andersonvnicius/TCC/Documentation/beforetext/agradecimentos.tex

\addtotextpreliminarycontent{\lang{Acknowledgement}{Agradecimentos}}

\begin{agradecimentos}

\lang
{
    Greetings.
}
{

    Os meus agradecimentos são direcionados aos meus professores orientadores, o professor Andrea Piga Carboni que me nestes
    últimos 3 anos me acompanhou e orientou com extrema atenção desde o planejamento do trabalho até sua conclusão,
    e ao meu co-orientador, e o professor Marcos Alves Rabelo, pela excelente orientação sempre que necessário, principalmente
    nas etapas experimentais do trabalho.

}

\end{agradecimentos}

%Mesmo padrão da seção primária, porém sem indicativo numérico. Assim como: Dedicatória, Resumo, Abstract, Sumário, Listas, Referências, Apêndices e Anexos.
%
%
%Corpo do texto, fonte 10,5, justificado, recuo especial da primeira linha de 1 cm, espaçamento simples.
%
