andersonvnicius/TCC/Documentation/beforetext/siglas.tex

%\addtotextpreliminarycontent{\lang{List of Acronyms}{Lista de Siglas}}
%
%\begin{siglas}
%    \item[ABNT] \lang{Brazilian Association of Technical Standards}{Associação Brasileira de Normas Técnicas}
%    \item[abnTeX] \lang{Absurd Standards for TeX}{ABsurdas Normas para TeX}
%\end{siglas}
