andersonvnicius/TCC/Documentation/pictures/1040.png

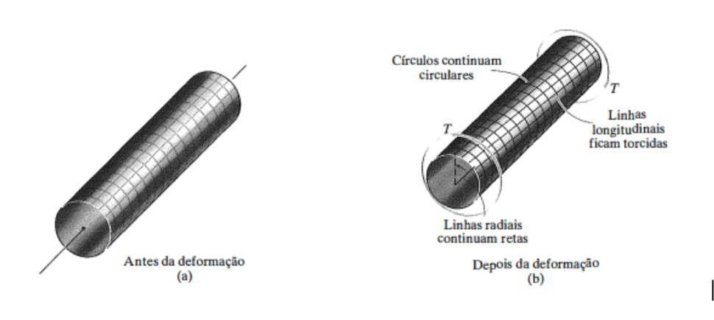
Documentation/pictures/1040.png
