andersonvnicius/TCC/Documentation/pictures/1050.png

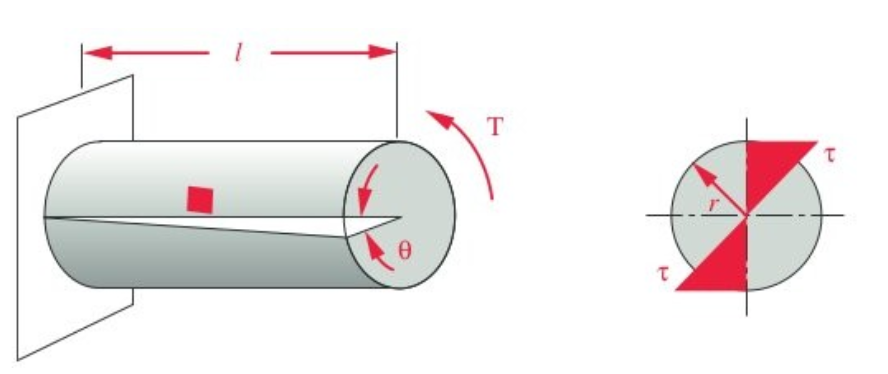
Documentation/pictures/1050.png
