andersonvnicius/TCC/Documentation/pictures/1130.jpg

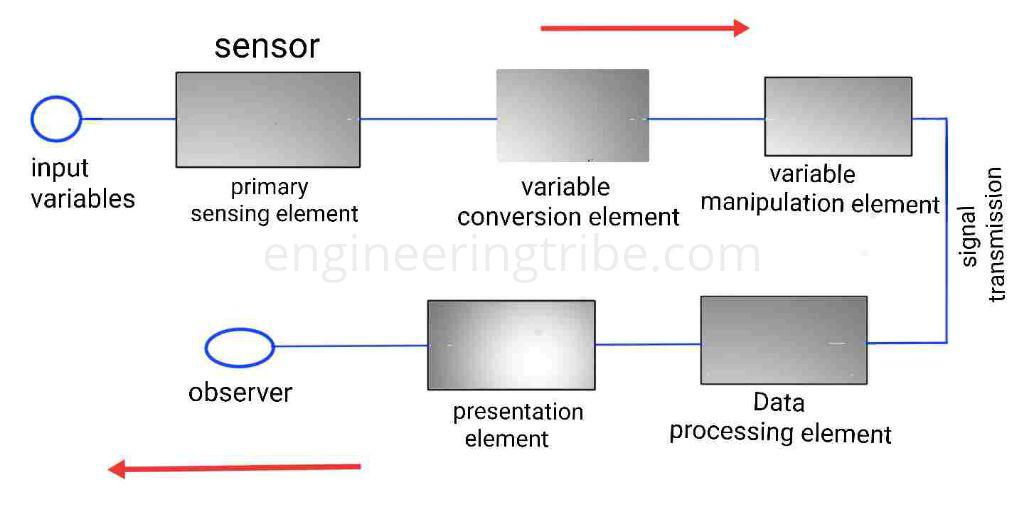
Documentation/pictures/1130.jpg
