andersonvnicius/TCC/Documentation/pictures/1140.png

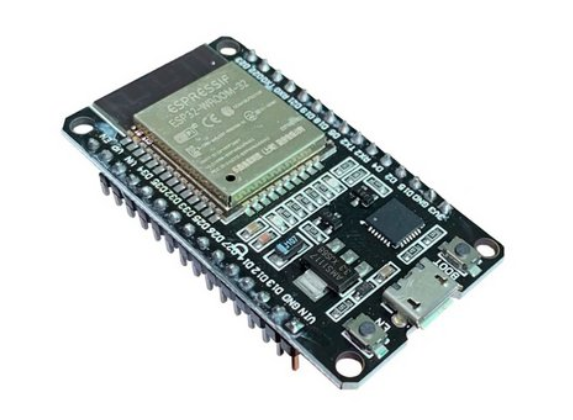
Documentation/pictures/1140.png
