andersonvnicius/TCC/Documentation/pictures/1160.png

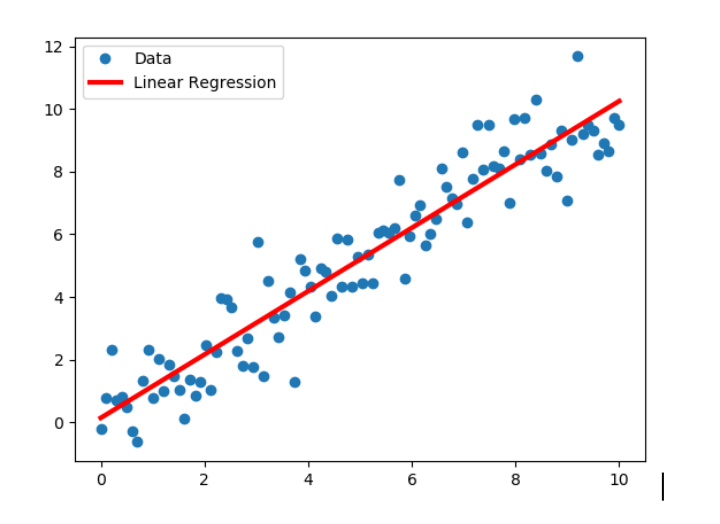
Documentation/pictures/1160.png
