andersonvnicius/TCC/Documentation/pictures/2020.jpg

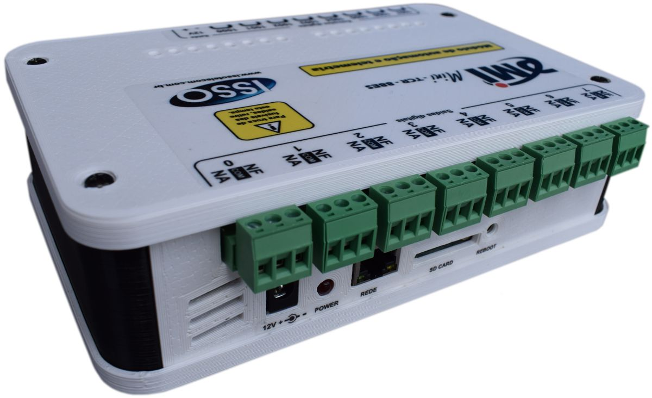
Documentation/pictures/2020.jpg
