andersonvnicius/TCC/Documentation/pictures/comp_func_reg.png

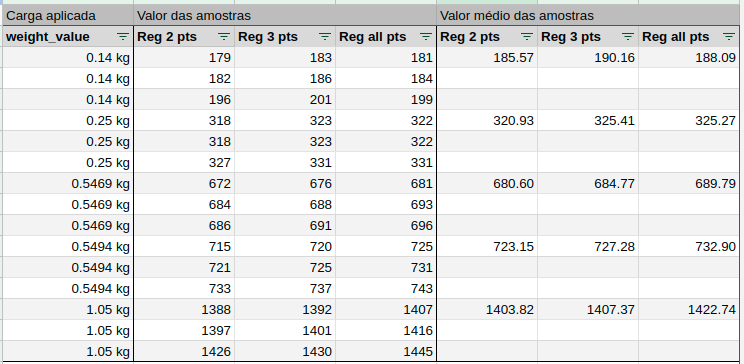
Documentation/pictures/comp_func_reg.png
