andersonvnicius/TCC/Documentation/pictures/comp_func_reg_erros.png

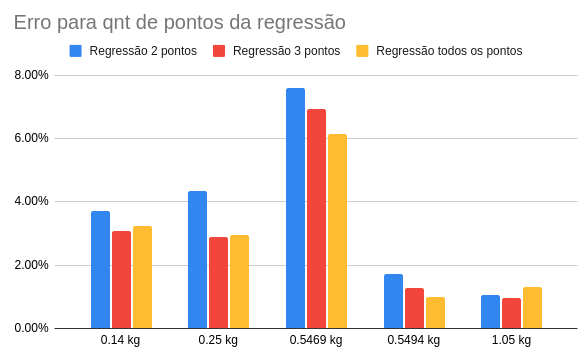
Documentation/pictures/comp_func_reg_erros.png
