andersonvnicius/TCC/Documentation/pictures/sep_24_1_deformation.png

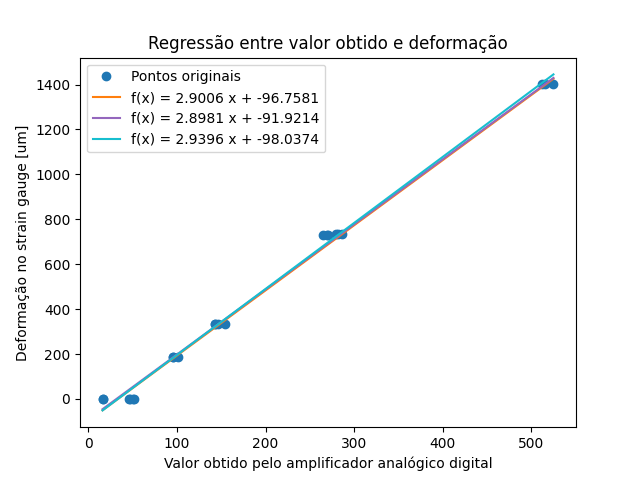
Documentation/pictures/sep_24_1_deformation.png
