andersonvnicius/TCC/Documentation/pictures/sep_24_1_weight.png

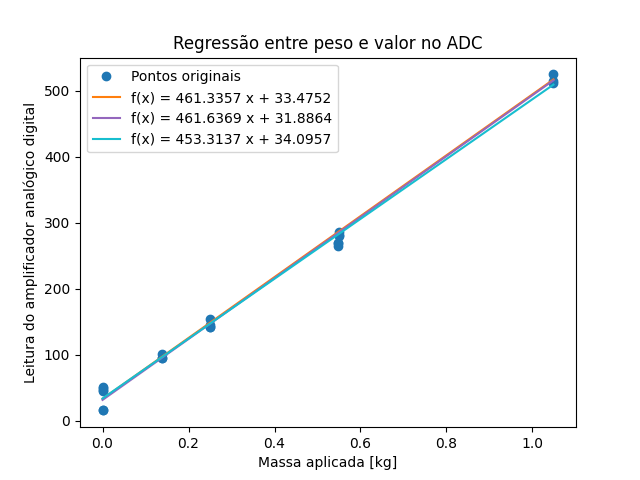
Documentation/pictures/sep_24_1_weight.png
