andersonvnicius/TCC/Documentation/pictures/t110.png

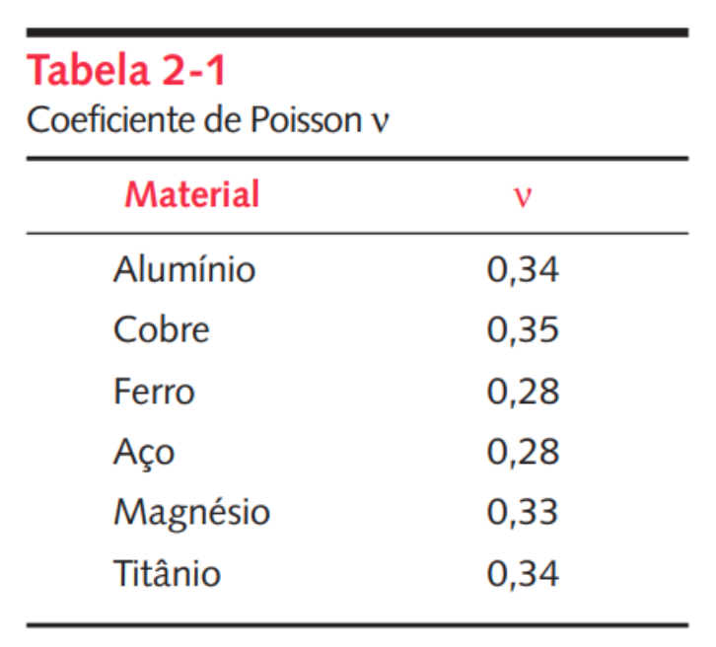
Documentation/pictures/t110.png
