andersonvnicius/TCC/Documentation/pictures/val_func_cal.png

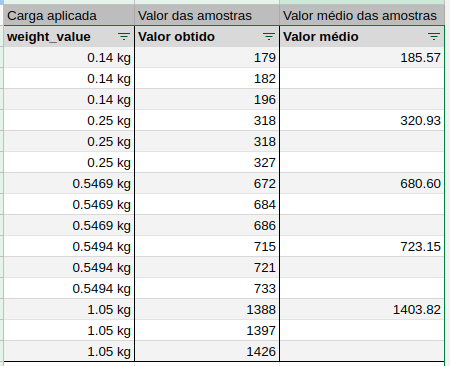
Documentation/pictures/val_func_cal.png
