andersonvnicius/TCC/Documentation/pictures/x_cal_0.png

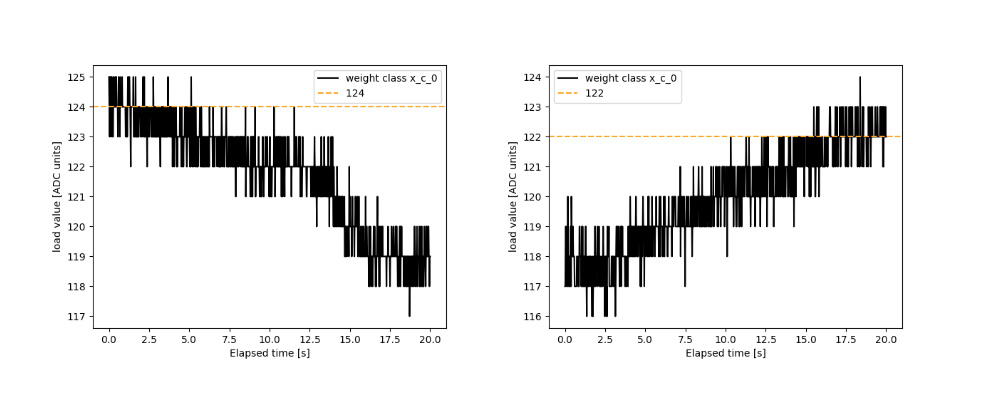
Documentation/pictures/x_cal_0.png
