andersonvnicius/TCC/Documentation/pictures/X_cal_1.png

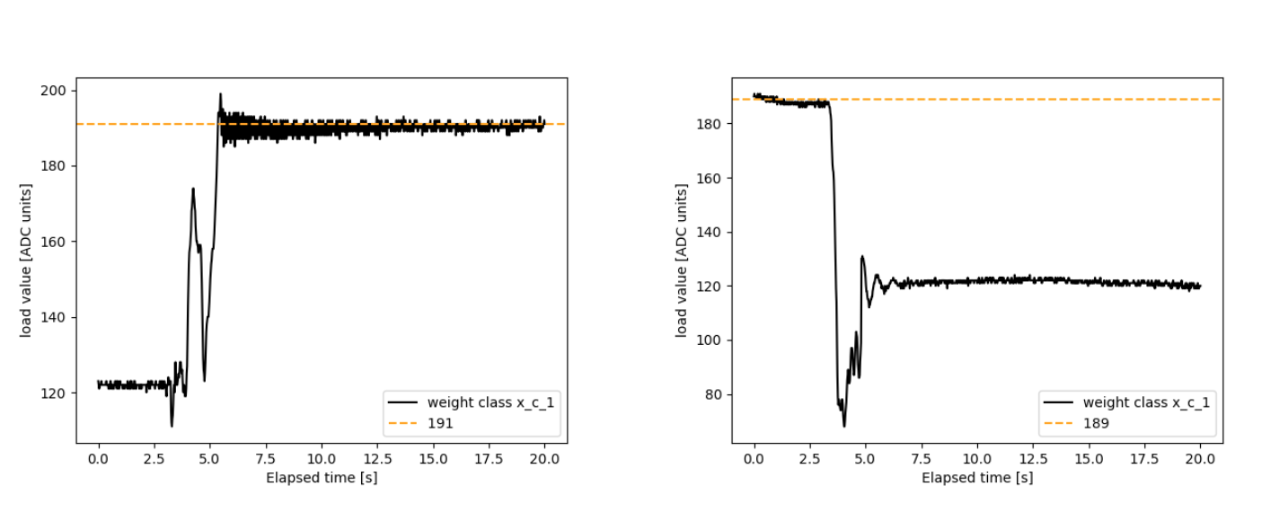
Documentation/pictures/X_cal_1.png
