andersonvnicius/TCC/Documentation/pictures/x_cal_4.png

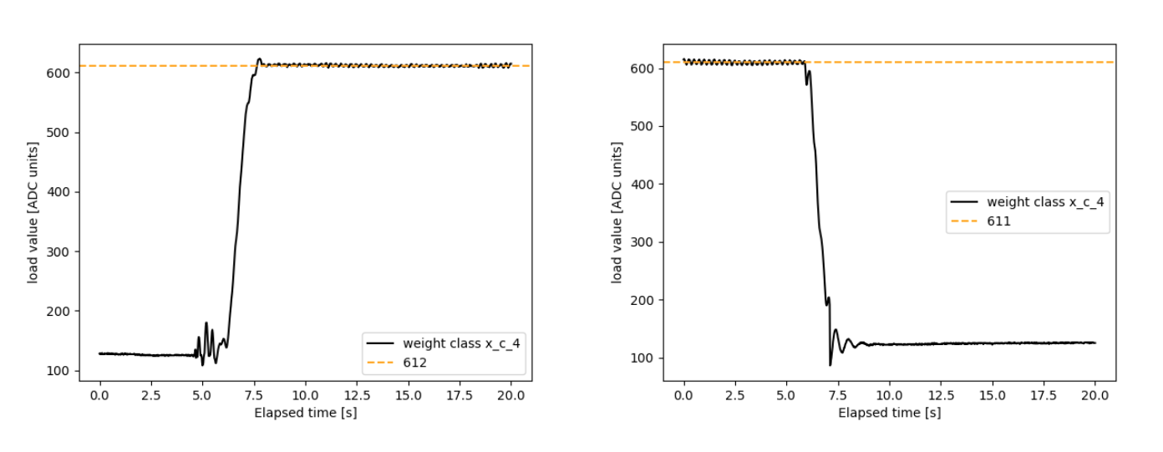
Documentation/pictures/x_cal_4.png
