andersonvnicius/TCC/results/jan_14_2022/x14h/Report_x_c_0_14_09_36_14_09_56_ADCunits.png

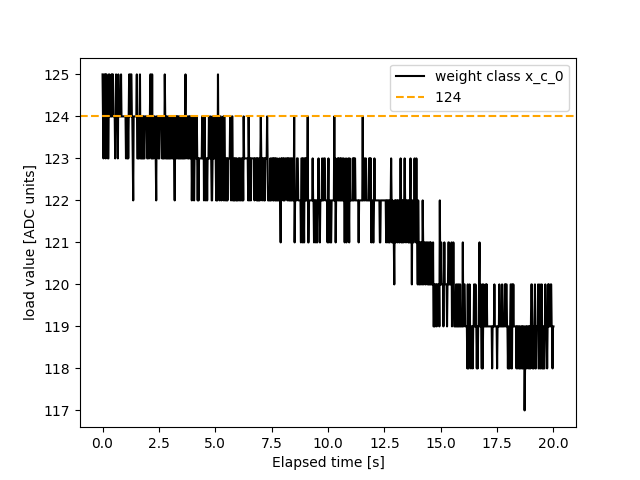
results/jan_14_2022/x14h/Report_x_c_0_14_09_36_14_09_56_ADCunits.png
