andersonvnicius/TCC/results/jan_14_2022/x14h/Report_x_c_0_14_10_30_14_10_50_ADCunits.png

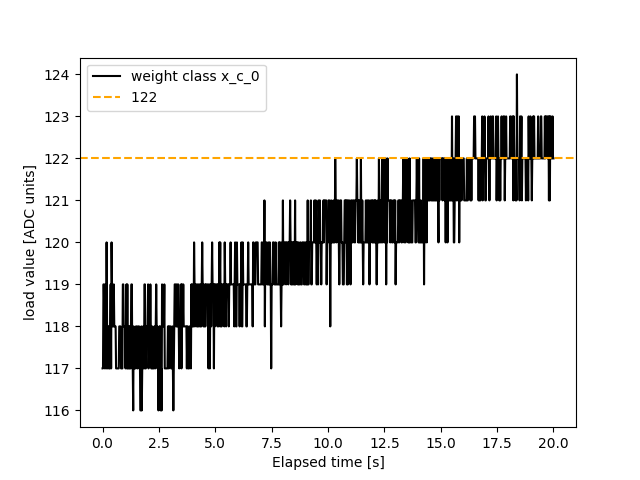
results/jan_14_2022/x14h/Report_x_c_0_14_10_30_14_10_50_ADCunits.png
