andersonvnicius/TCC/results/jan_14_2022/x14h/Report_x_c_1_14_11_29_14_11_49_ADCunits.png

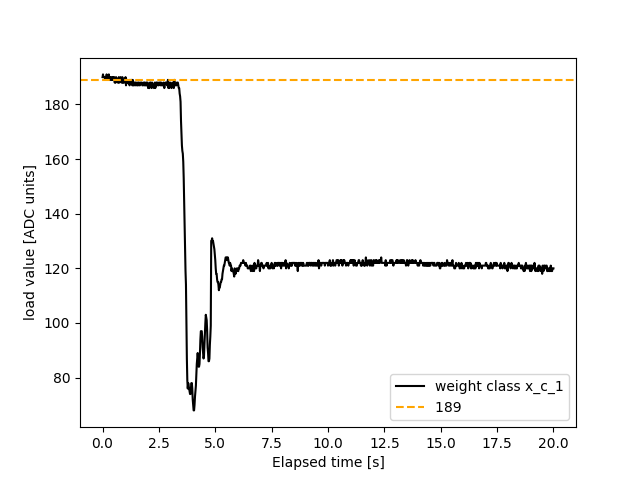
results/jan_14_2022/x14h/Report_x_c_1_14_11_29_14_11_49_ADCunits.png
