andersonvnicius/TCC/results/jan_14_2022/x14h/Report_x_c_1_14_12_20_14_12_40_ADCunits.png

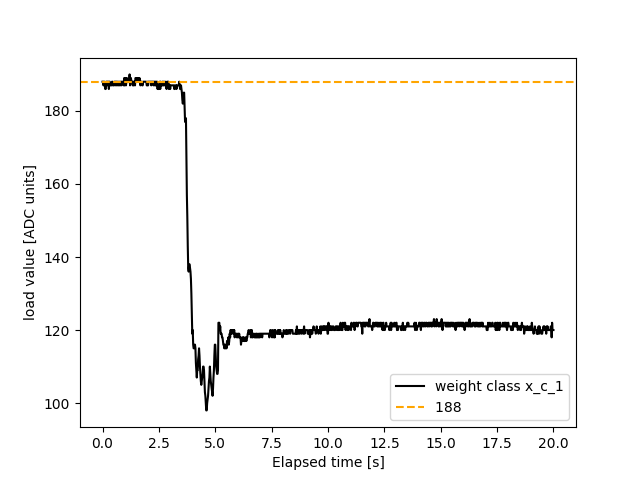
results/jan_14_2022/x14h/Report_x_c_1_14_12_20_14_12_40_ADCunits.png
