andersonvnicius/TCC/results/jan_14_2022/x14h/Report_x_c_4_14_13_38_14_13_58_ADCunits.png

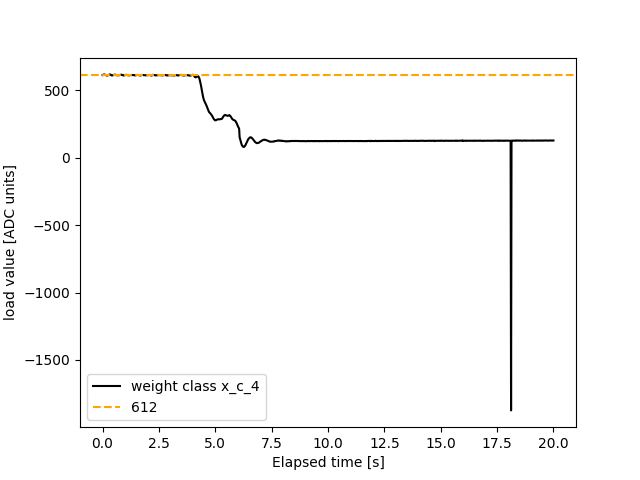
results/jan_14_2022/x14h/Report_x_c_4_14_13_38_14_13_58_ADCunits.png
