andersonvnicius/TCC/results/jan_14_2022/x14h/Report_x_c_4_14_14_31_14_14_51_ADCunits.png

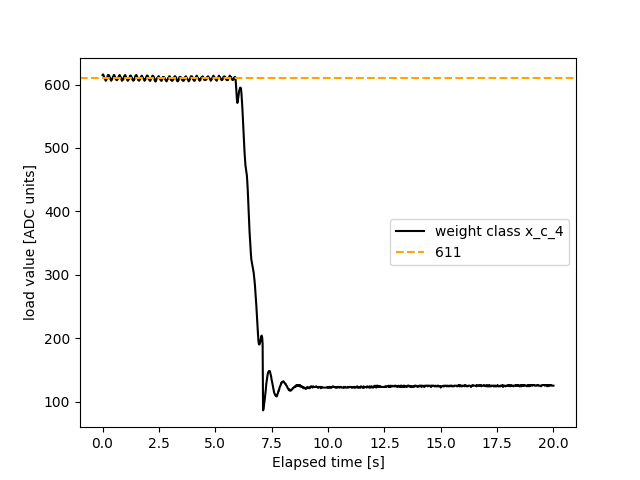
results/jan_14_2022/x14h/Report_x_c_4_14_14_31_14_14_51_ADCunits.png
