andersonvnicius/TCC/results/jan_14_2022/x14h/Report_x_c_r_0_14_15_26_14_15_46_ADCunits.png

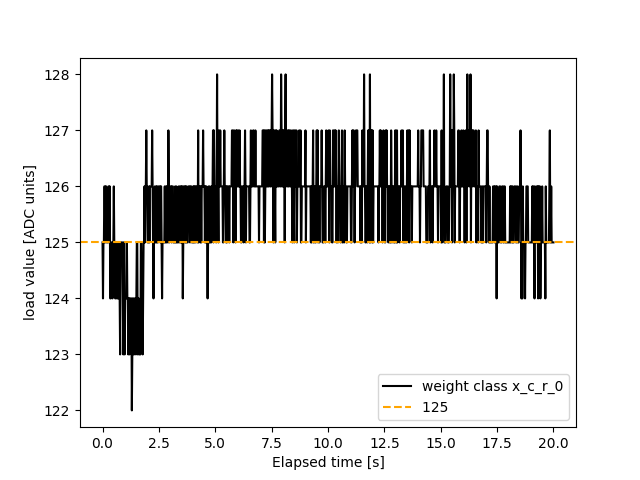
results/jan_14_2022/x14h/Report_x_c_r_0_14_15_26_14_15_46_ADCunits.png
