andersonvnicius/TCC/results/jan_14_2022/x14h/Report_x_c_r_0_14_15_58_14_16_18_ADCunits.png

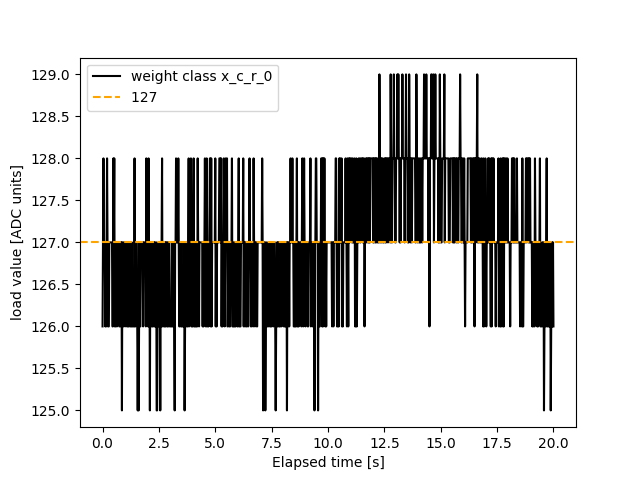
results/jan_14_2022/x14h/Report_x_c_r_0_14_15_58_14_16_18_ADCunits.png
