andersonvnicius/TCC/results/jan_14_2022/x14h/Report_x_c_r_1_2_14_21_25_14_21_45_ADCunits.png

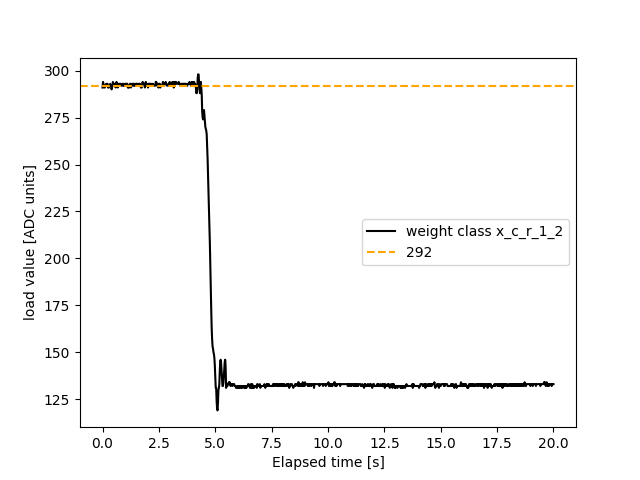
results/jan_14_2022/x14h/Report_x_c_r_1_2_14_21_25_14_21_45_ADCunits.png
