andersonvnicius/TCC/results/jan_14_2022/x14h/Report_x_c_r_1_14_16_52_14_17_12_ADCunits.png

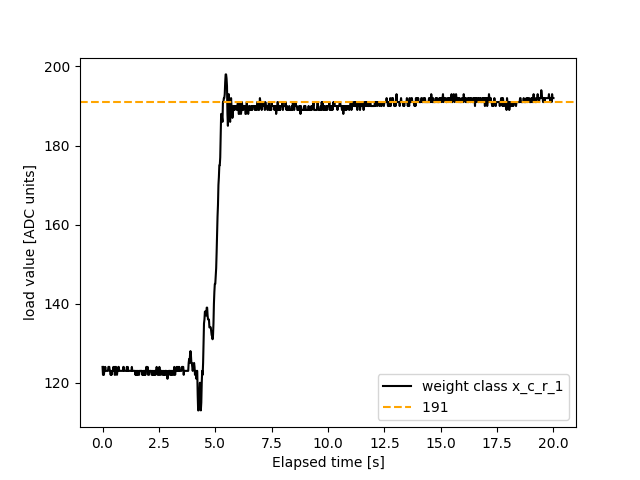
results/jan_14_2022/x14h/Report_x_c_r_1_14_16_52_14_17_12_ADCunits.png
