andersonvnicius/TCC/results/jan_14_2022/x14h/Report_x_c_r_1_14_17_15_14_17_35_ADCunits.png

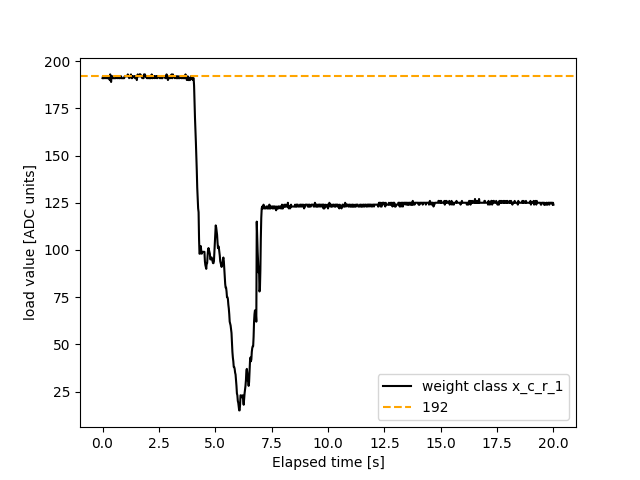
results/jan_14_2022/x14h/Report_x_c_r_1_14_17_15_14_17_35_ADCunits.png
