andersonvnicius/TCC/results/jan_14_2022/x14h/Report_x_c_r_2_14_18_55_14_19_15_ADCunits.png

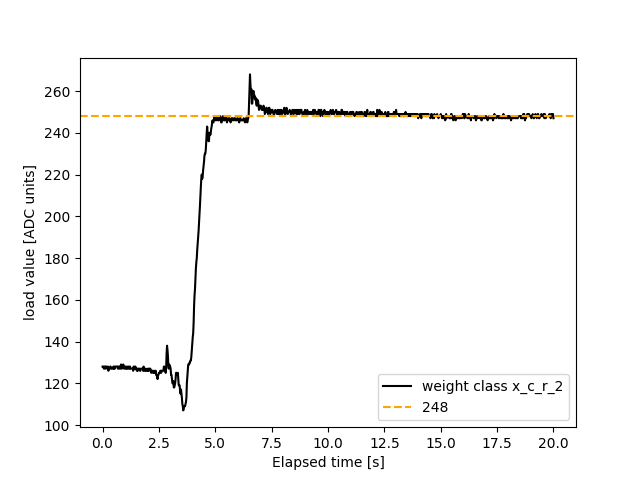
results/jan_14_2022/x14h/Report_x_c_r_2_14_18_55_14_19_15_ADCunits.png
