andersonvnicius/TCC/results/jan_14_2022/x14h/Report_x_c_r_3_a_14_23_44_14_24_04_ADCunits.png

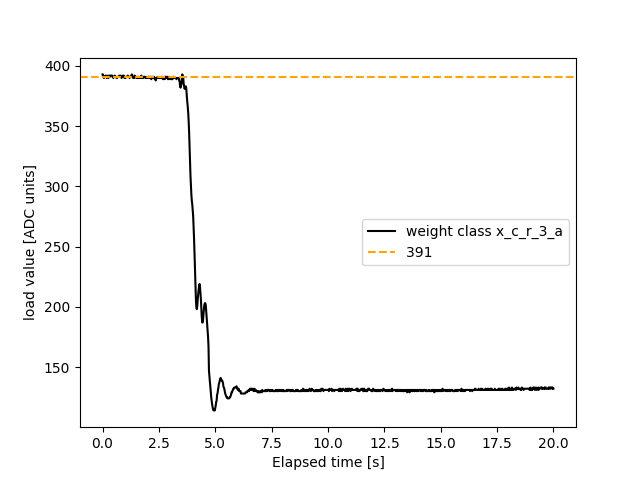
results/jan_14_2022/x14h/Report_x_c_r_3_a_14_23_44_14_24_04_ADCunits.png
