andersonvnicius/TCC/results/jan_14_2022/x14h/Report_x_c_r_3_a_14_24_28_14_24_48_ADCunits.png

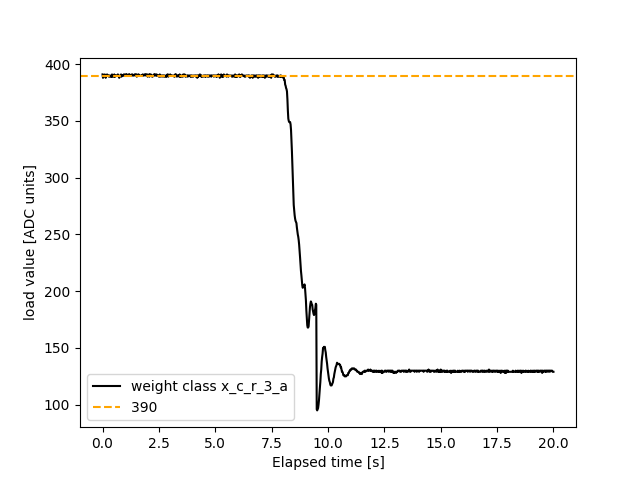
results/jan_14_2022/x14h/Report_x_c_r_3_a_14_24_28_14_24_48_ADCunits.png
