andersonvnicius/TCC/results/jan_14_2022/x14h/Report_x_c_r_3_a_p_1_14_26_04_14_26_24_ADCunits.png

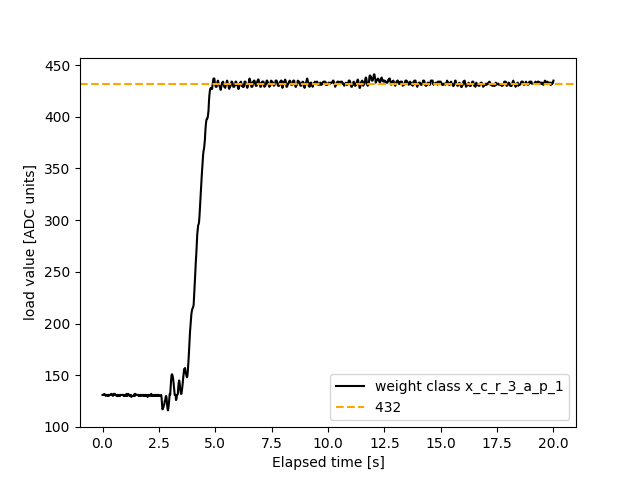
results/jan_14_2022/x14h/Report_x_c_r_3_a_p_1_14_26_04_14_26_24_ADCunits.png
