andersonvnicius/TCC/results/jan_14_2022/x14h/Report_x_c_r_3_a_p_2_p_1_14_29_46_14_30_06_ADCunits.png

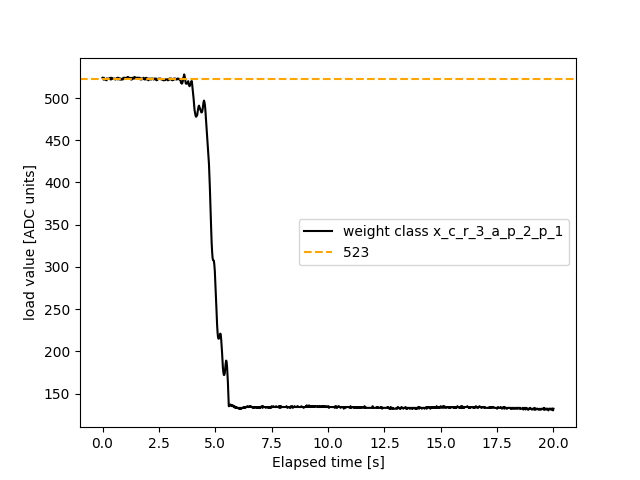
results/jan_14_2022/x14h/Report_x_c_r_3_a_p_2_p_1_14_29_46_14_30_06_ADCunits.png
