andersonvnicius/TCC/results/jan_14_2022/x14h/Report_x_c_r_3_a_p_2_p_1_14_30_33_14_30_53_ADCunits.png

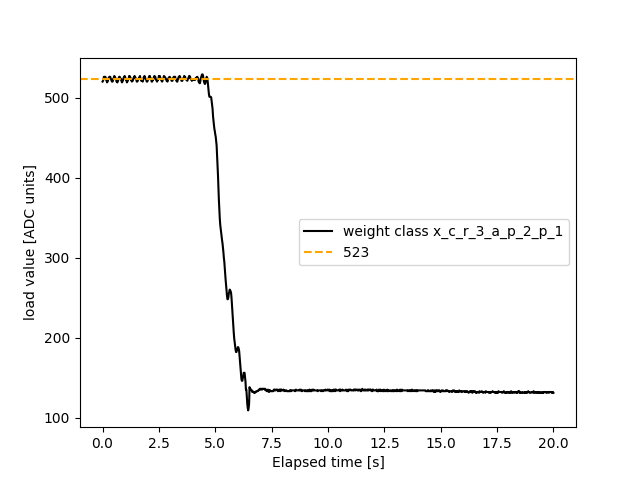
results/jan_14_2022/x14h/Report_x_c_r_3_a_p_2_p_1_14_30_33_14_30_53_ADCunits.png
