andersonvnicius/TCC/results/jan_14_2022/x14h/Report_x_c_r_4_14_31_27_14_31_47_ADCunits.png

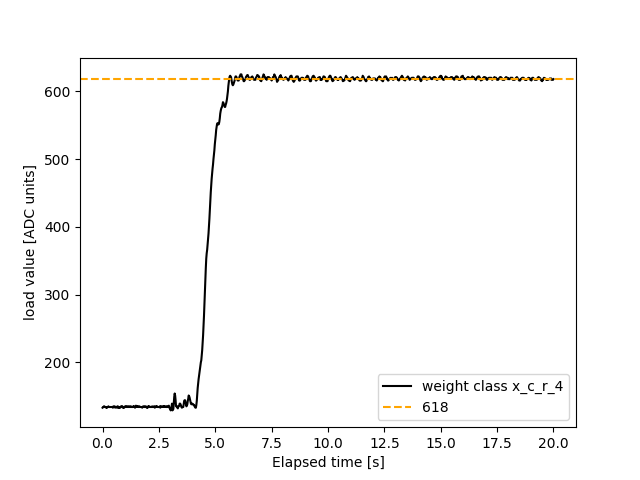
results/jan_14_2022/x14h/Report_x_c_r_4_14_31_27_14_31_47_ADCunits.png
