andersonvnicius/TCC/results/jan_14_2022/x14h/Report_x_c_r_4_p_1_14_39_47_14_40_07_ADCunits.png

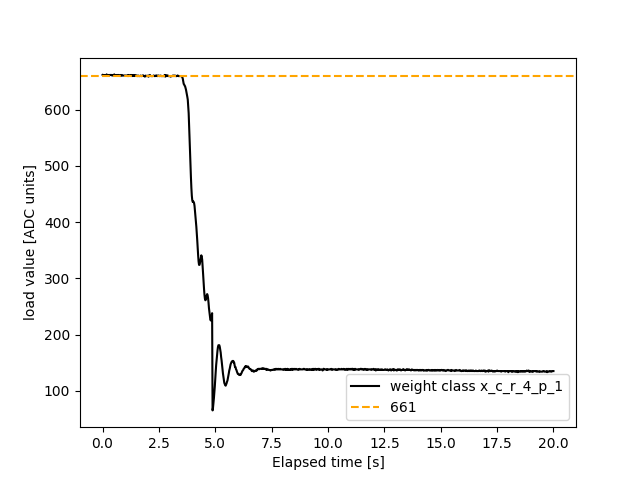
results/jan_14_2022/x14h/Report_x_c_r_4_p_1_14_39_47_14_40_07_ADCunits.png
