andersonvnicius/TCC/results/jan_14_2022/x14h/Report_x_c_r_4_p_1_14_40_40_14_41_00_ADCunits.png

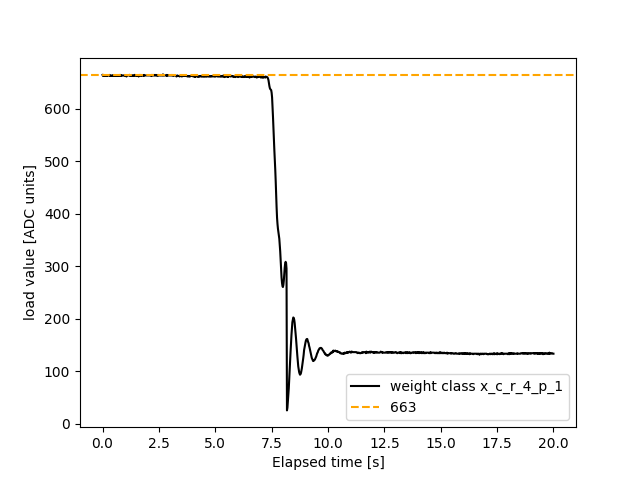
results/jan_14_2022/x14h/Report_x_c_r_4_p_1_14_40_40_14_41_00_ADCunits.png
