andersonvnicius/TCC/results/jan_14_2022/x14h/Report_x_c_r_4_p_2_14_41_28_14_41_48_ADCunits.png

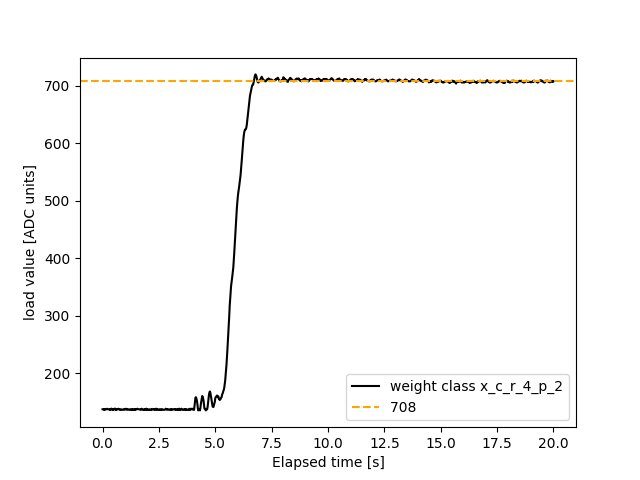
results/jan_14_2022/x14h/Report_x_c_r_4_p_2_14_41_28_14_41_48_ADCunits.png
