andersonvnicius/TCC/results/jan_14_2022/x14h/Report_x_c_r_4_p_2_p_1_14_43_55_14_44_15_ADCunits.png

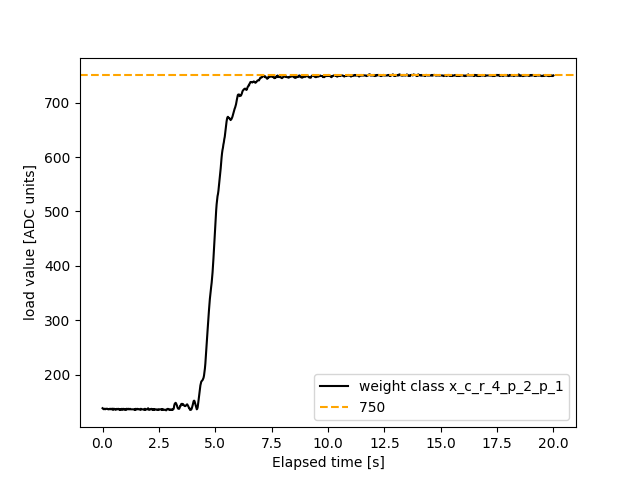
results/jan_14_2022/x14h/Report_x_c_r_4_p_2_p_1_14_43_55_14_44_15_ADCunits.png
