andersonvnicius/TCC/results/sep_24_1/Report_0_16_10_19_16_12_19.png

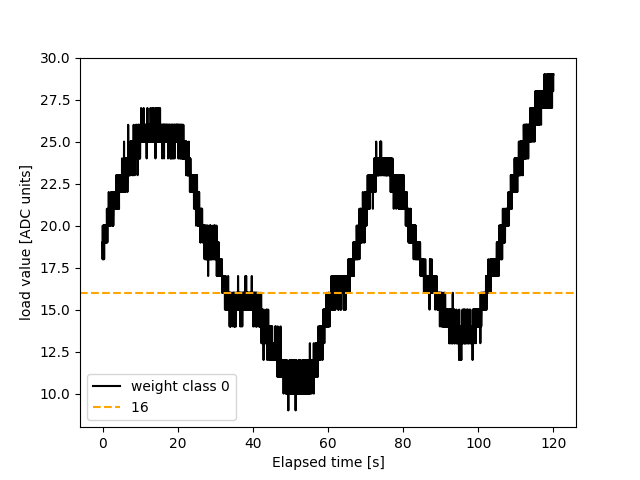
results/sep_24_1/Report_0_16_10_19_16_12_19.png
