andersonvnicius/TCC/results/sep_24_1/Report_0_16_32_59_16_33_59.png

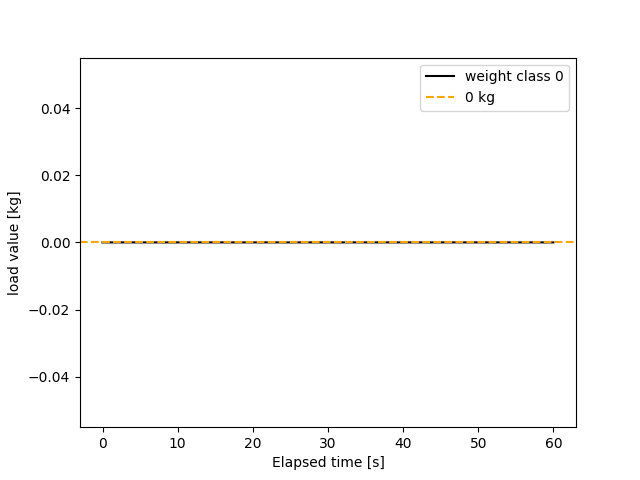
results/sep_24_1/Report_0_16_32_59_16_33_59.png
