andersonvnicius/TCC/results/sep_24_1/Report_0_16_32_59_16_33_59_ADCunits.png

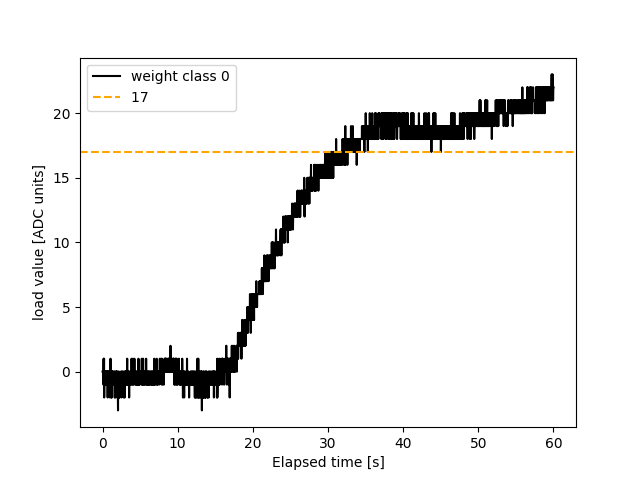
results/sep_24_1/Report_0_16_32_59_16_33_59_ADCunits.png
