andersonvnicius/TCC/results/sep_24_1/Report_w_0_16_13_36_16_14_36.png

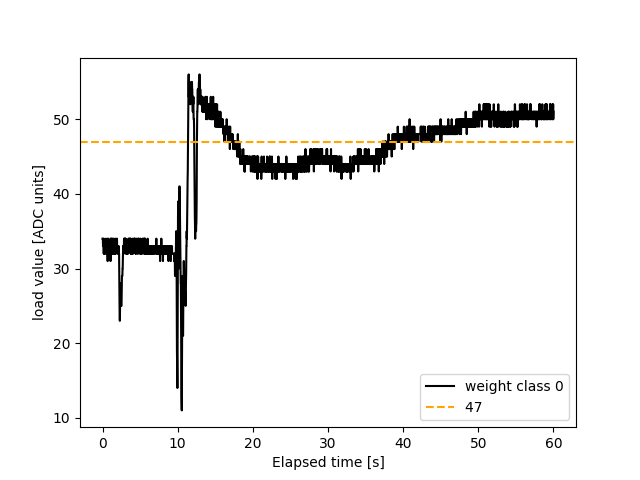
results/sep_24_1/Report_w_0_16_13_36_16_14_36.png
