andersonvnicius/TCC/results/sep_24_1/Report_w_0_16_14_37_16_15_37.png

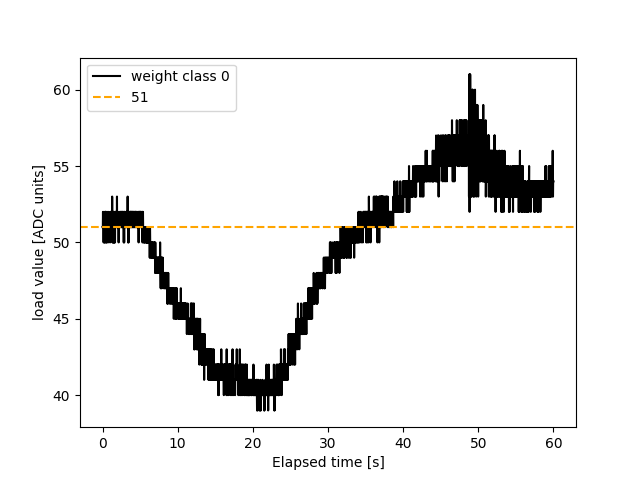
results/sep_24_1/Report_w_0_16_14_37_16_15_37.png
