andersonvnicius/TCC/results/sep_24_1/Report_w_0_16_30_10_16_31_10_ADCunits.png

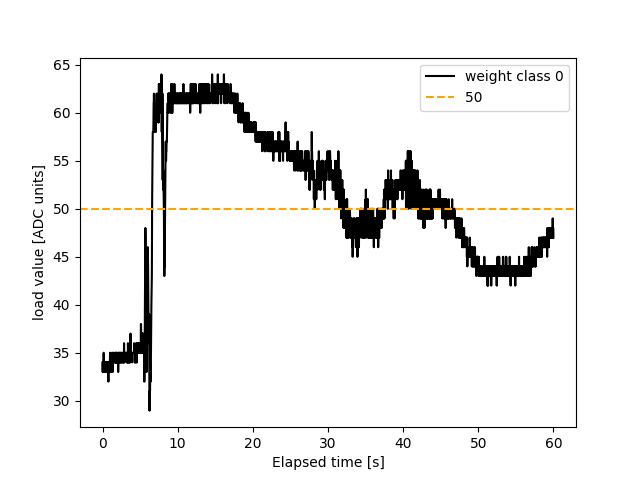
results/sep_24_1/Report_w_0_16_30_10_16_31_10_ADCunits.png
