andersonvnicius/TCC/results/sep_24_1/Report_w_0_16_31_16_16_32_16_ADCunits.png

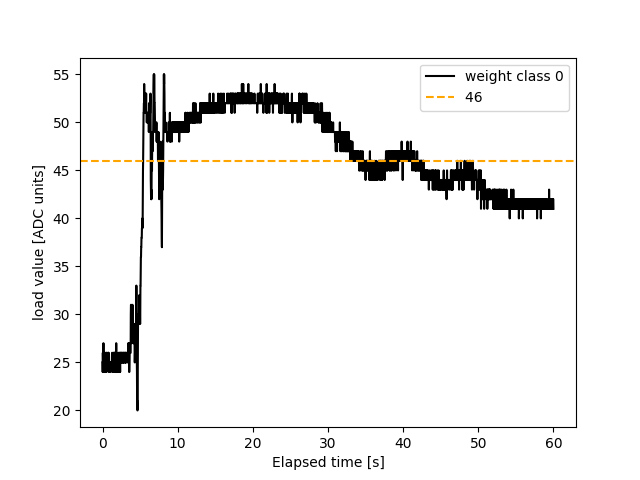
results/sep_24_1/Report_w_0_16_31_16_16_32_16_ADCunits.png
