andersonvnicius/TCC/results/sep_24_1/Report_w_1_16_19_36_16_20_36.png

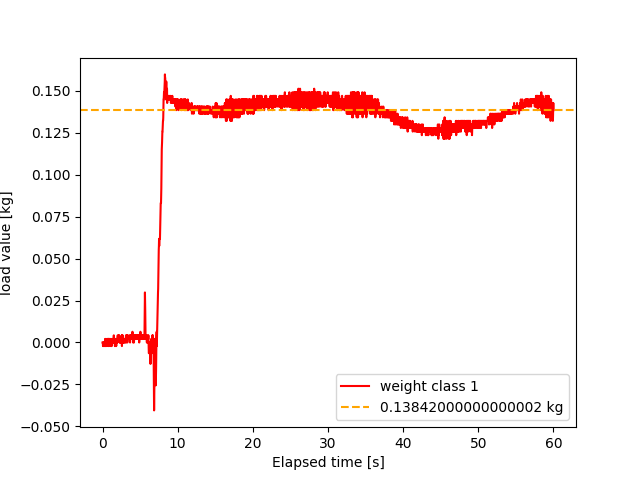
results/sep_24_1/Report_w_1_16_19_36_16_20_36.png
