andersonvnicius/TCC/results/sep_24_1/Report_w_1_16_27_35_16_28_35.png

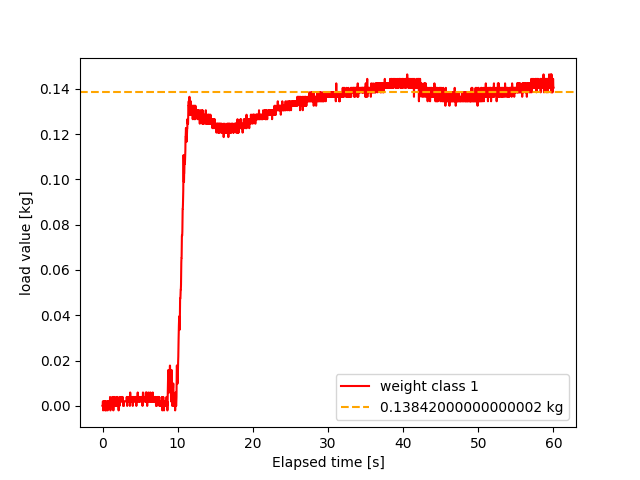
results/sep_24_1/Report_w_1_16_27_35_16_28_35.png
