andersonvnicius/TCC/results/sep_24_1/Report_w_1_16_28_44_16_29_44.png

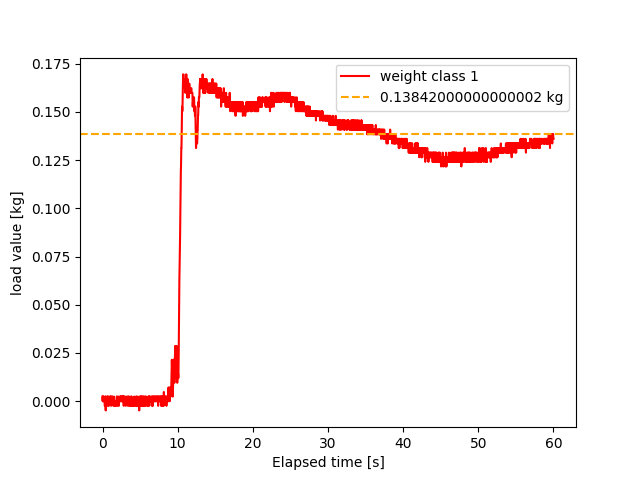
results/sep_24_1/Report_w_1_16_28_44_16_29_44.png
