andersonvnicius/TCC/results/sep_24_1/Report_w_2_16_22_06_16_23_06.png

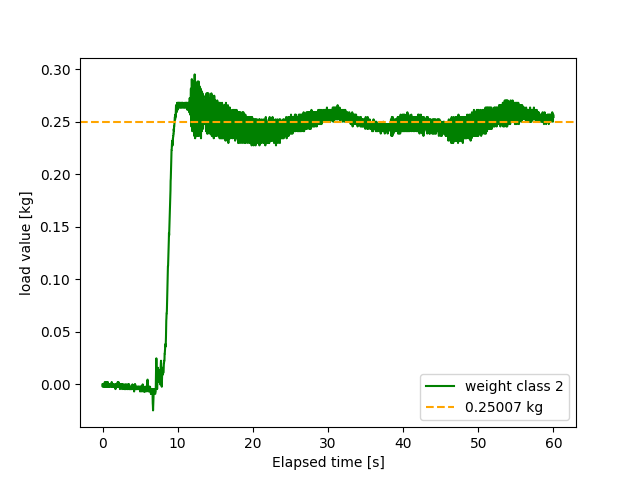
results/sep_24_1/Report_w_2_16_22_06_16_23_06.png
