andersonvnicius/TCC/results/sep_24_1/Report_w_2_16_23_21_16_24_21.png

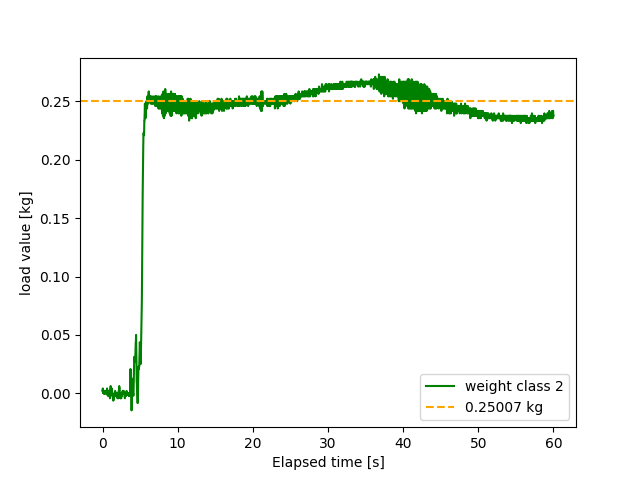
results/sep_24_1/Report_w_2_16_23_21_16_24_21.png
