andersonvnicius/TCC/results/sep_24_1/Report_w_3_16_45_49_16_46_49.png

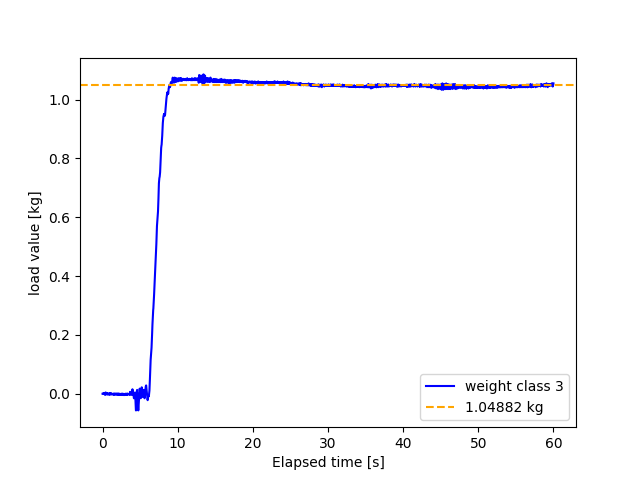
results/sep_24_1/Report_w_3_16_45_49_16_46_49.png
