andersonvnicius/TCC/results/sep_24_1/Report_w_3_16_48_16_16_49_16.png

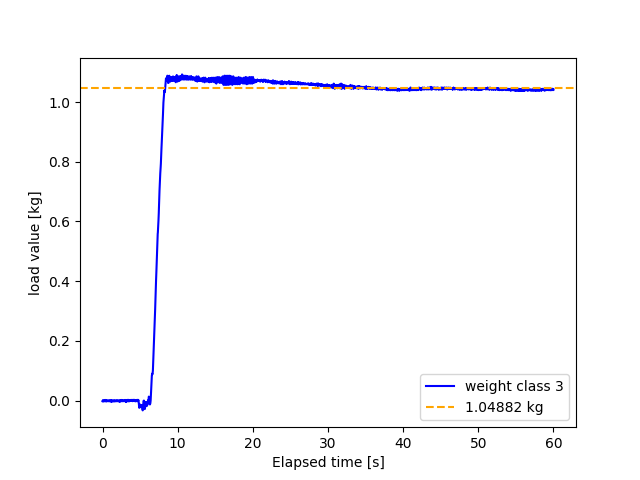
results/sep_24_1/Report_w_3_16_48_16_16_49_16.png
