andersonvnicius/TCC/results/sep_24_1/Report_w_a_16_34_07_16_35_07.png

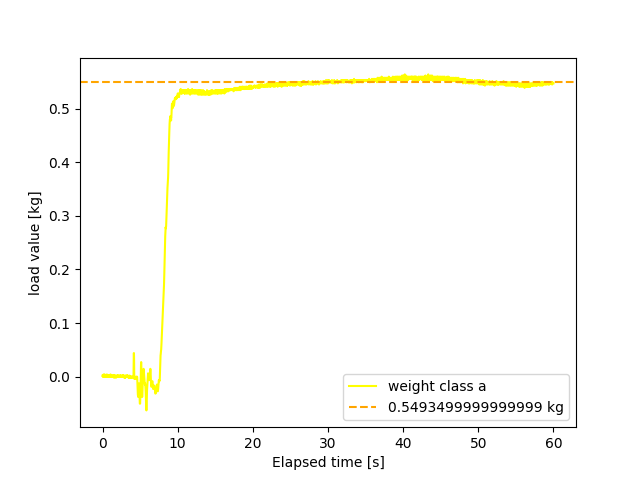
results/sep_24_1/Report_w_a_16_34_07_16_35_07.png
