andersonvnicius/TCC/results/sep_24_1/Report_w_a_16_35_13_16_36_13_ADCunits.png

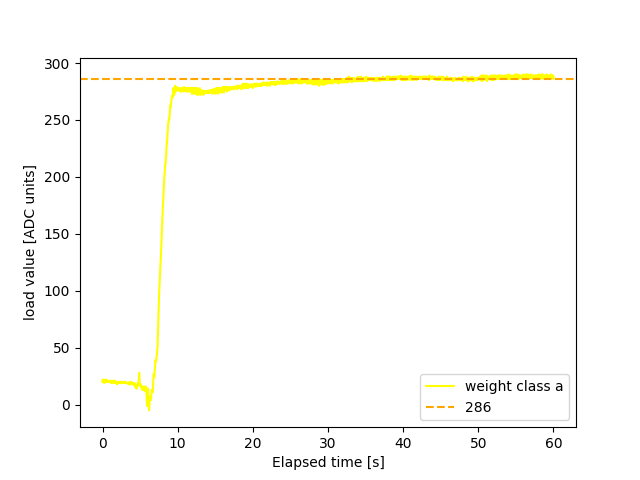
results/sep_24_1/Report_w_a_16_35_13_16_36_13_ADCunits.png
