andersonvnicius/TCC/results/sep_24_1/Report_w_a_16_43_17_16_44_17.png

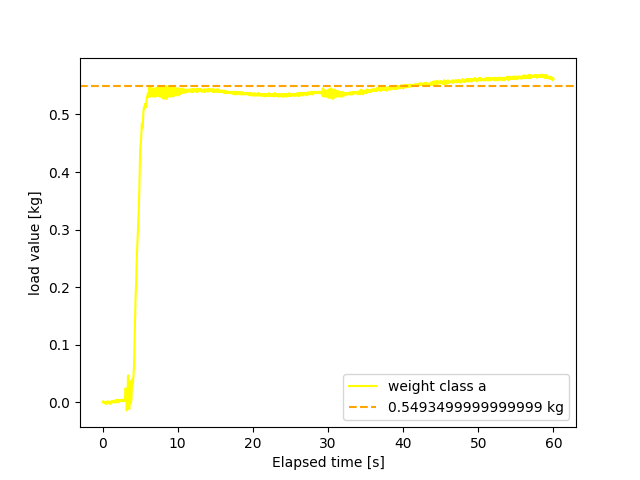
results/sep_24_1/Report_w_a_16_43_17_16_44_17.png
