andersonvnicius/TCC/results/sep_24_1/Report_w_b_16_36_22_16_37_22.png

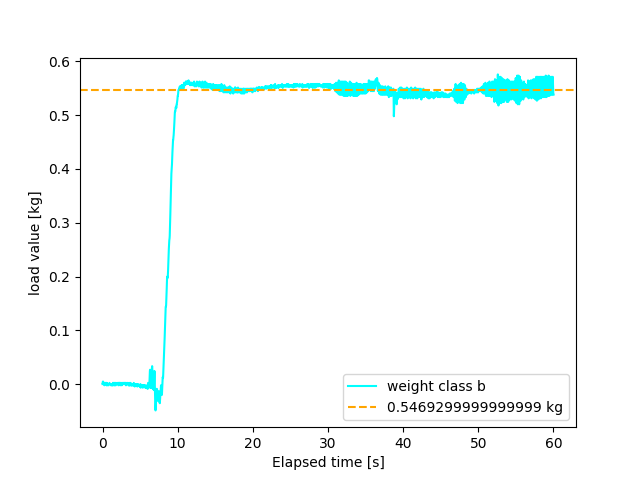
results/sep_24_1/Report_w_b_16_36_22_16_37_22.png
