andersonvnicius/TCC/results/sep_24_1/Report_w_b_16_38_26_16_39_26.png

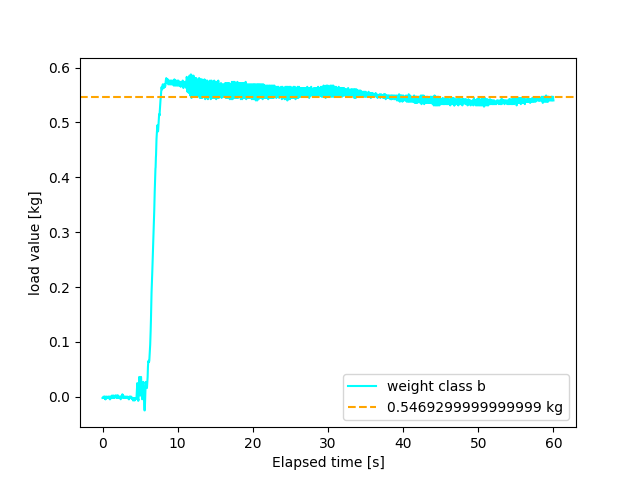
results/sep_24_1/Report_w_b_16_38_26_16_39_26.png
