andersonvnicius/TCC/results/sep_24_1/Report_w_b_16_41_29_16_42_29_ADCunits.png

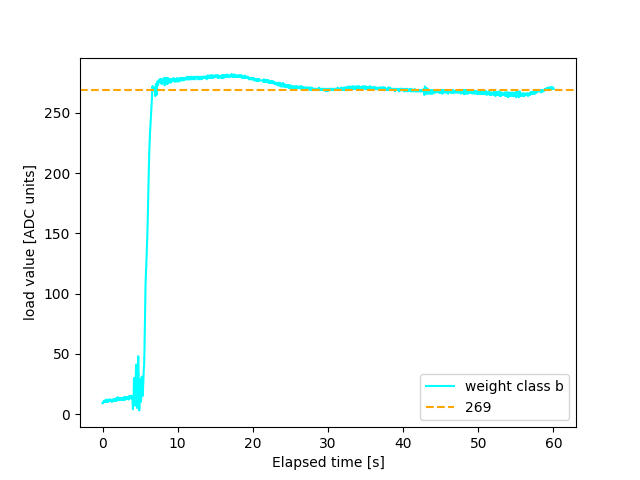
results/sep_24_1/Report_w_b_16_41_29_16_42_29_ADCunits.png
