andersonvnicius/TCC/scripts/Examples/Figure_1.png

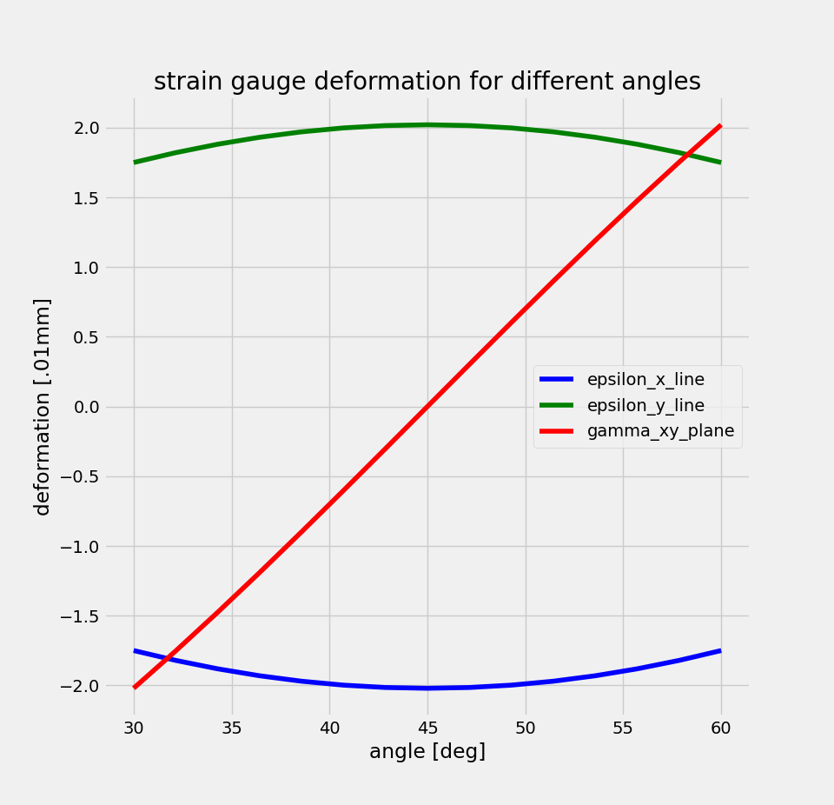
scripts/Examples/Figure_1.png
