andersonvnicius/TCC/scripts/Examples/Figure_2.png

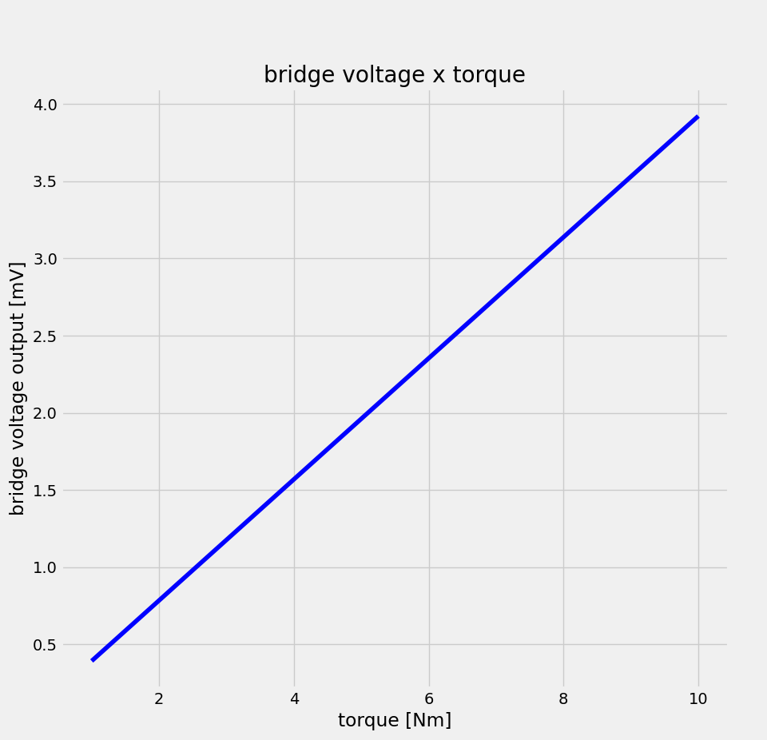
scripts/Examples/Figure_2.png
