andersonvnicius/TCC/results/read_1.csv

 | read
0 | -46.0
1 | 41.0
2 | 58.0
3 | -48.0
4 | 16.0
5 | 225.0
6 | 5909.0
7 | -170.0
8 | -52.0
9 | 6003.0
10 | 16311.0
11 | 22857.0
12 | 19512.0
13 | 26247.0
14 | 26083.0
15 | 26076.0
16 | 26280.0
17 | 26335.0
18 | 26207.0
19 | 26081.0
20 | 26172.0
21 | 26181.0
22 | 26317.0
23 | 26086.0
24 | 26041.0
25 | 26093.0
26 | 26141.0
27 | 26300.0
28 | 26194.0
29 | 26167.0
30 | 26209.0
31 | 26266.0
32 | 26251.0
33 | 26256.0
34 | 26259.0
35 | 26400.0
36 | 26172.0
37 | 26282.0
38 | 26282.0
39 | 26190.0
40 | 26286.0
41 | 26374.0
42 | 26164.0
43 | 26205.0
44 | 26152.0
45 | 26223.0
46 | 26061.0
47 | 26361.0
48 | 26212.0
49 | 26232.0
50 | 26434.0
51 | 26229.0
52 | 26098.0
53 | 26184.0
54 | 26311.0
55 | 26222.0
56 | 26272.0
57 | 26333.0
58 | 26083.0
59 | 26263.0
60 | 26127.0
61 | 26099.0
62 | 26136.0
63 | 26132.0
64 | 26224.0
65 | 26116.0
66 | 26185.0
67 | 26306.0
68 | 26330.0
69 | 26138.0
70 | 26227.0
71 | 26272.0
72 | 26196.0
73 | 26130.0
74 | 26101.0
75 | 26376.0
76 | 26253.0
77 | 26116.0
78 | 26178.0
79 | 26336.0
80 | 26204.0
81 | 26489.0
82 | 26392.0
83 | 26101.0
84 | 26299.0
85 | 26270.0
86 | 26227.0
87 | 26213.0
88 | 26265.0
89 | 26435.0
90 | 26233.0
91 | 26194.0
92 | 26365.0
93 | 26205.0
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
