andersonvnicius/TCC/results/read_2.csv

 | read
0 | 35.0
1 | 346.0
2 | 39.0
3 | -49.0
4 | -13.0
5 | 13.0
6 | -292.0
7 | -25.0
8 | 110.0
9 | 158.0
10 | 98.0
11 | 18.0
12 | 1215.0
13 | 75972.0
14 | 104560.0
15 | 98507.0
16 | 103858.0
17 | 106423.0
18 | 106137.0
19 | 106347.0
20 | 106300.0
21 | 106334.0
22 | 106409.0
23 | 106396.0
24 | 106460.0
25 | 106560.0
26 | 106416.0
27 | 106302.0
28 | 106418.0
29 | 106362.0
30 | 106194.0
31 | 106103.0
32 | 106277.0
33 | 106293.0
34 | 106248.0
35 | 106351.0
36 | 106479.0
37 | 106295.0
38 | 106056.0
39 | 106288.0
40 | 106529.0
41 | 106357.0
42 | 106396.0
43 | 106425.0
44 | 106270.0
45 | 106259.0
46 | 106058.0
47 | 106276.0
48 | 106254.0
49 | 106205.0
50 | 106277.0
51 | 106306.0
52 | 106072.0
53 | 106409.0
54 | 106471.0
55 | 106360.0
56 | 106375.0
57 | 105893.0
58 | 106230.0
59 | 106089.0
60 | 106545.0
61 | 106294.0
62 | 106358.0
63 | 106594.0
64 | 106282.0
65 | 106000.0
66 | 105900.0
67 | 106233.0
68 | 106438.0
69 | 106343.0
70 | 106245.0
71 | 106154.0
72 | 106338.0
73 | 106142.0
74 | 106401.0
75 | 106408.0
76 | 106538.0
77 | 106351.0
78 | 106627.0
79 | 106079.0
80 | 106442.0
81 | 106133.0
82 | 106262.0
83 | 106376.0
84 | 106392.0
85 | 106412.0
86 | 106266.0
87 | 106322.0
88 | 106274.0
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
