andersonvnicius/TCC/results/sep_24_1_results.csv

weight_class | weight_value | strain_value | time_start | time_end | read_offset | read_load | linreg_1 | linreg_2 | linreg_3
0 | 0.0 | 0.0 | 16:10:19 | 16:12:19 | 20 | 16 | -50.34848044936305 | -45.55150114178531 | -51.00310265343018
0 | 0.0 | 0.0 | 16:32:59 | 16:33:59 | -1 | 17 | -47.44787987149036 | -42.65338261405503 | -48.063458043238185
0 | 0.0 | 0.0 | 16:31:16 | 16:32:16 | 25 | 46 | 36.669536886817724 | 41.392054690123075 | 37.18623565232974
0 | 0.0 | 0.0 | 16:13:36 | 16:14:36 | 33 | 47 | 39.57013746469042 | 44.29017321785335 | 40.12588026252175
0 | 0.0 | 0.0 | 16:30:10 | 16:31:10 | 34 | 50 | 48.2719391983085 | 52.98452880104418 | 48.94481409309773
0 | 0.0 | 0.0 | 16:14:37 | 16:15:37 | 51 | 51 | 51.172539776181196 | 55.88264732877445 | 51.88445870328971
1 | 0.13842000000000002 | 185.3061326365375 | 16:28:44 | 16:29:44 | 37 | 95 | 178.79896520257967 | 183.39986254890675 | 181.2288215517376
1 | 0.13842000000000002 | 185.3061326365375 | 16:19:36 | 16:20:36 | 31 | 96 | 181.69956578045236 | 186.29798107663703 | 184.1684661619296
1 | 0.13842000000000002 | 185.3061326365375 | 16:27:35 | 16:28:35 | 31 | 101 | 196.20256866981583 | 200.7885737152884 | 198.86668921288958
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
