andersonvnicius/TCC/results/test_2022-02-28 19:04:22.028798.csv

 | read
0 | 3.0
1 | 3.0
2 | 3.0
3 | 3.0
4 | 3.0
5 | 3.0
6 | 3.0
7 | 3.0
8 | 3.0
9 | 3.0
10 | 3.0
11 | 3.0
12 | 3.0
13 | 3.0
14 | 3.0
15 | 3.0
16 | 23.0
17 | 32.0
18 | 31.0
19 | 31.0
20 | 31.0
21 | 31.0
22 | 31.0
23 | 31.0
24 | 31.0
25 | 31.0
26 | 31.0
27 | 31.0
28 | 31.0
29 | 31.0
30 | 31.0
31 | 31.0
32 | 31.0
33 | 31.0
34 | 31.0
35 | 31.0
36 | 43.0
37 | 46.0
38 | 46.0
39 | 46.0
40 | 46.0
41 | 45.0
42 | 45.0
43 | 46.0
44 | 46.0
45 | 46.0
46 | 46.0
47 | 46.0
48 | 46.0
49 | 45.0
50 | 46.0
51 | 46.0
52 | 46.0
53 | 46.0
54 | 46.0
55 | 45.0
56 | 46.0
57 | 46.0
58 | 46.0
59 | 45.0
60 | 46.0
61 | 46.0
62 | 46.0
63 | 45.0
64 | 45.0
65 | 45.0
66 | 46.0
67 | 59.0
68 | 8.0
69 | -3374.0
70 | 97.0
71 | 97.0
72 | 99.0
73 | 99.0
74 | 99.0
75 | 99.0
76 | 99.0
77 | 99.0
78 | 99.0
79 | 99.0
80 | 99.0
81 | 99.0
82 | 99.0
83 | 99.0
84 | 99.0
85 | 99.0
86 | 99.0
87 | 99.0
88 | 99.0
89 | 99.0
90 | 99.0
91 | 99.0
92 | 99.0
93 | 99.0
94 | 99.0
95 | 99.0
96 | 99.0
97 | 99.0
98 | 99.0
99 | 99.0
100 | 99.0
101 | 99.0
102 | 99.0
103 | 99.0
104 | 99.0
105 | 99.0
106 | 99.0
107 | 99.0
108 | 99.0
109 | 99.0
110 | 99.0
111 | 99.0
112 | 99.0
113 | 99.0
114 | 99.0
115 | 99.0
116 | 99.0
117 | 99.0
118 | 99.0
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
