andersonvnicius/TCC/results/jan_14_2022/x14h_deformation.png

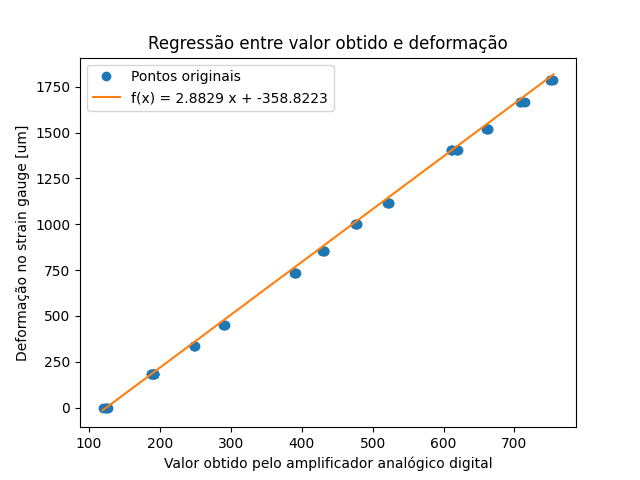
results/jan_14_2022/x14h_deformation.png
