andersonvnicius/TCC/(commit log)

2021-06-01 inserted documentation about stuff that still needs to be done into each file docstring
2021-06-08 Added arduino programming for the device
2021-09-24 added reports
    [Report_fuse_and_nutg_15_15_21_15_15_31.csv, Report_fuse_and_nutg_15_16_19_15_16_30.csv, Report_fuse_and_nutg_15_22_43_15_22_53.csv, Report_fuse_and_nutg_15_32_47_15_32_49.csv, Report_fuse_and_nutg_15_32_52_15_32_54.csv, Report_fuse_and_nutg_15_32_57_15_32_59.csv, Report_fuse_and_nutg_15_33_12_15_33_14.csv, Report_fuse_and_nutg_15_33_18_15_33_20.csv]
2021-11-10 stuff added
    [sep_24_1_results.csv]
2021-11-10 a little bit every day
    [sep_24_1_results.csv]
2022-02-07 added a bunch of stuff
    [Report_c_0_13_39_19_13_39_39.csv, Report_c_0_13_39_45_13_40_05.csv, Report_c_0_13_40_06_13_40_26.csv, Report_c_0_13_43_58_13_44_18.csv, Report_c_0_13_44_24_13_44_44.csv, Report_c_0_13_44_47_13_45_07.csv, Report_c_1_13_45_19_13_45_39.csv, Report_c_1_13_45_51_13_46_11.csv]
2022-02-26 device is finally working in wireless mode
2022-02-28 MAJOR UPDATE: the device is now working in web server mode
    [Report_0_15_24_09_15_24_10.csv, Report_0_15_28_12_15_28_43.csv, Report_0_16_09_50_16_09_55.csv, Report_0_16_10_19_16_12_19.csv, Report_0_16_32_59_16_33_59.csv, Report_0_o_f_f_s_e_t_15_30_23_15_30_54.csv, Report_c_0_13_39_19_13_39_39.csv, Report_c_0_13_39_45_13_40_05.csv]
2022-02-28 more stuff
    [read_1.csv, read_2.csv, test_2022-02-28 19:04:22.028798.csv]
